AJMartel/defusable_arduino_shield/README.md

# Defusable Alarm Clock Shield for Arduino

Deze github bevat de software, datasheets en referentie materiaal incl. printplaat bestanden van het Defusable Alarm Clock Shield voor Arduino.

J.A. Korten - 2017
