AJMartel/defusable_arduino_shield/Hardware/Shield 1.2/7Segments_displays.png

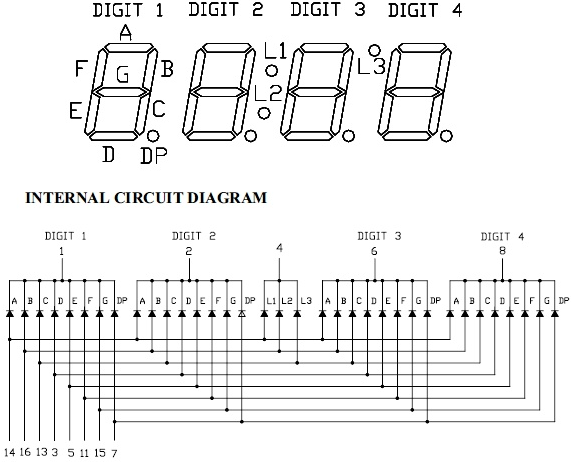
Hardware/Shield 1.2/7Segments_displays.png
