AJMartel/defusable_arduino_shield/Hardware/Shield 1.2/led_matrix_scham.png

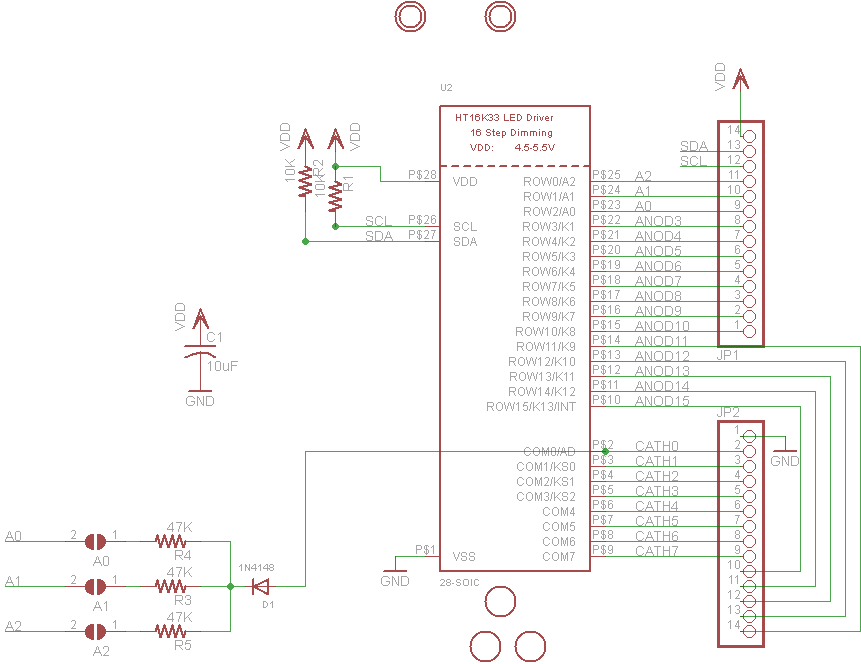
Hardware/Shield 1.2/led_matrix_scham.png
