AJMartel/defusable_arduino_shield/Hardware/Shield 1.2/bombclock_1.3.brd

## EAGLE design Hardware/Shield 1.2/bombclock_1.3.brd (2017-04-16)

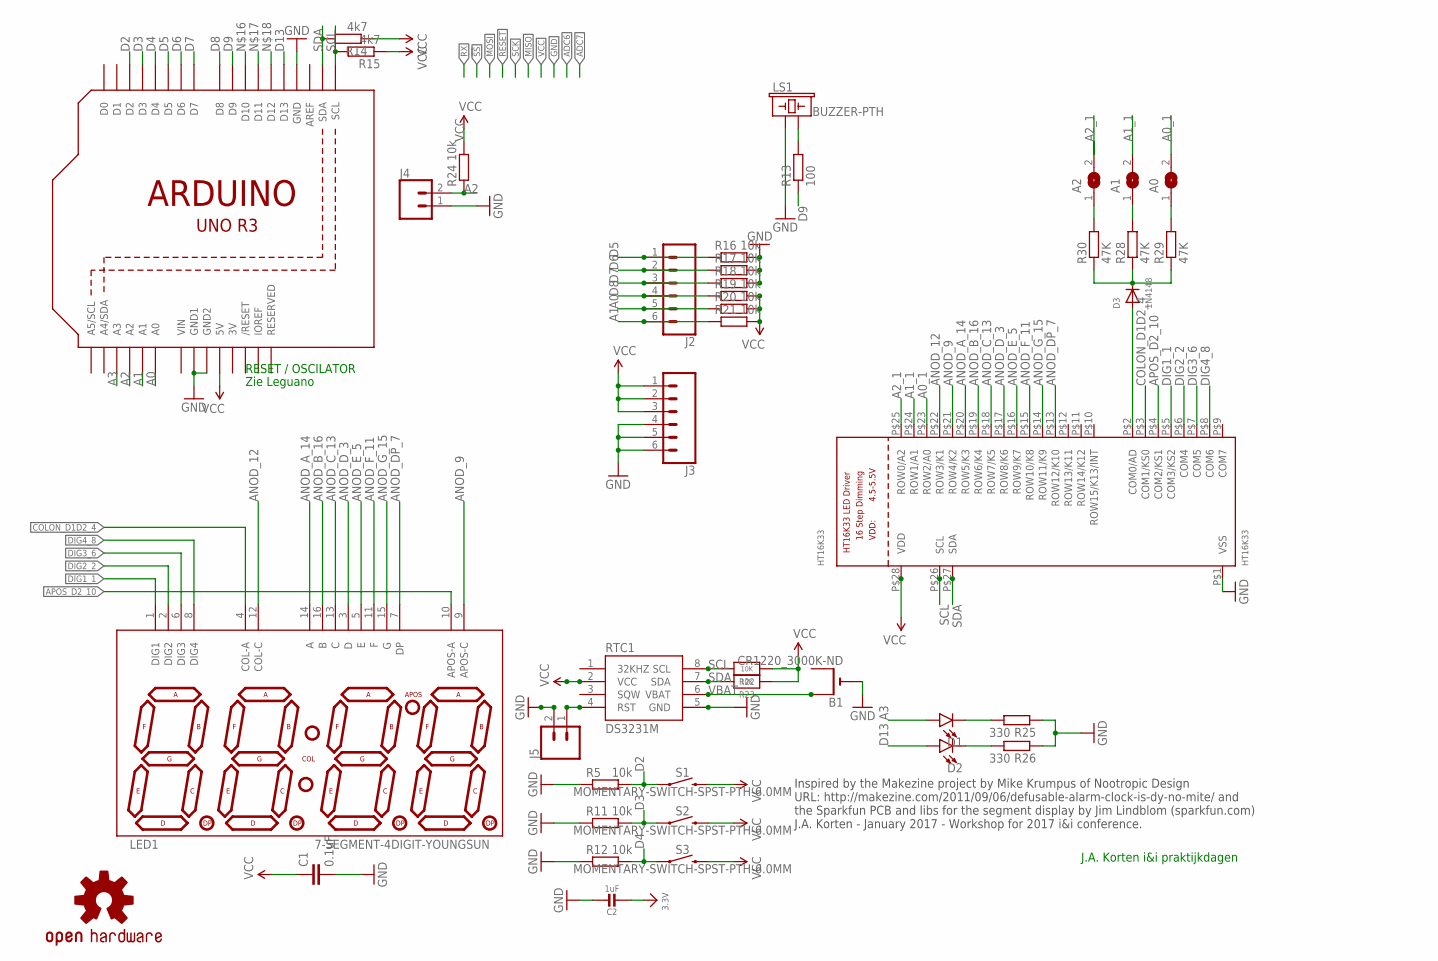
[picture p26: schematic bombclock_1.3.sch]

Parts:
A0, A1, A2: SOLDERJUMPERREFLOW_NOPASTE; SOLDERJUMPER_REFLOW_NOPASTE
B1: CR1220_3000K-ND; CR1220-SMD
C1: 0.1uF; 0402-CAP
C2: 1uF; 0805-NO
D1, D2: LED5MM; LED_5MM
D3: 1N4148; SOD-323F
HT16K33: HT16K33; SOP28_300MIL
J2, J3: CONN_06SILK_FEMALE_PTH; 1X06
J4, J5: CONN_02; 1X02
LED1: 7-SEGMENT-4DIGIT-YOUNGSUN
LS1: BUZZER-PTH; BUZZER-12MM
R5, R11, R12, R16, R17, R18, R19, R20, R21, R24: 10k; R0603
R13: 100; R0603
R14, R15: 4k7; R0603
R22, R23: 10K; 0805-NO
R25, R26: 330; R0603
R28, R29, R30: 47K; R0603
RTC1: DS3231M; SO08
S1, S2, S3: MOMENTARY-SWITCH-SPST-PTH-6.0MM; TACTILE_SWITCH_PTH_6.0MM
U1: ARDUINOR3-DIMENSION; ARDUINOR3
U$4: OSHW-LOGOS; OSHW-LOGO-S

Connections:
3.3V: C2.2
3V: U1.3V
A0: J2.5, R20.1, U1.A0
A0_1: A0.2, HT16K33.P$23 (ROW2/A0)
A1: J2.6, R21.1, U1.A1
A1_1: A1.2, HT16K33.P$24 (ROW1/A1)
A2: J4.2, R24.1, U1.A2
A2_1: A2.2, HT16K33.P$25 (ROW0/A2)
A3: D1.A, U1.A3
ANOD_9: HT16K33.P$21 (ROW4/K2), LED1.9 (APOS-C)
ANOD_12: HT16K33.P$22 (ROW3/K1), LED1.12 (COL-C)
ANOD_A_14: HT16K33.P$20 (ROW5/K3), LED1.14 (A)
ANOD_B_16: HT16K33.P$19 (ROW6/K4), LED1.16 (B)
ANOD_C_13: HT16K33.P$18 (ROW7/K5), LED1.13 (C)
ANOD_DP_7: HT16K33.P$13 (ROW12/K10), LED1.7 (DP)
ANOD_D_3: HT16K33.P$17 (ROW8/K6), LED1.3 (D)
ANOD_E_5: HT16K33.P$16 (ROW9/K7), LED1.5 (E)
ANOD_F_11: HT16K33.P$15 (ROW10/K8), LED1.11 (F)
ANOD_G_15: HT16K33.P$14 (ROW11/K9), LED1.15 (G)
APOS_D2_10: HT16K33.P$4 (COM2/KS1), LED1.10 (APOS-A)
COLON_D1D2_4: HT16K33.P$3 (COM1/KS0), LED1.4 (COL-A)
D2: R5.2, S1.1, U1.D2
D3: R11.2, S2.1, U1.D3
D4: R12.2, S3.1, U1.D4
D5: J2.1, R16.1, U1.D5
D6: J2.2, R17.1, U1.D6
D7: J2.3, R18.1, U1.D7
D8: J2.4, R19.1, U1.D8
D9: R13.1, U1.D9
D13: D2.A, U1.D13
DIG1_1: HT16K33.P$5 (COM3/KS2), LED1.1 (DIG1)
DIG2_2: HT16K33.P$6 (COM4), LED1.2 (DIG2)
DIG3_6: HT16K33.P$7 (COM5), LED1.6 (DIG3)
DIG4_8: HT16K33.P$8 (COM6), LED1.8 (DIG4)
GND: B1.-, C1.2, C2.1, HT16K33.P$1 (VSS), J3.4, J3.5, J3.6, J4.1, J5.2, LS1.+ (1), R5.1, R11.1, R12.1, R16.2, R17.2, R18.2, R25.1, R26.1, RTC1.5 (GND), U1.GND, U1.GND1, U1.GND2
unnamed: A0.1, R29.2
unnamed: D3.A, HT16K33.P$2 (COM0/AD)
unnamed: D1.K (C), R25.2
unnamed: D2.K (C), R26.2
unnamed: A1.1, R28.2
unnamed: LS1.- (2), R13.2
unnamed: D3.C, R28.1, R29.1, R30.1
unnamed: A2.1, R30.2
PP: J5.1, RTC1.4 (RST)
SCL: HT16K33.P$26 (SCL), R15.2, R22.2, RTC1.8 (SCL), U1.SCL
SDA: HT16K33.P$27 (SDA), R14.2, R23.2, RTC1.7 (SDA), U1.SDA
VBAT: B1.+$1 (+), RTC1.6 (VBAT)
VCC: C1.1, HT16K33.P$28 (VDD), J3.1, J3.2, J3.3, R14.1, R15.1, R19.2, R20.2, R21.2, R22.1, R23.1, R24.2, RTC1.2 (VCC), S1.3 (2), S2.3 (2), S3.3 (2), U1.5V
VIN: U1.VIN

Notes on the sheet:
Inspired by the Makezine project by Mike Krumpus of Nootropic Design URL: http://makezine.com/2011/09/06/defusable-alarm-clock-is-dy-no-mite/ and the Sparkfun PCB and libs for the segment display by Jim Lindblom (sparkfun.com) J.A. Korten - January 2017 - Workshop for 2017 i&i conference.
RESET / OSCILATOR
Zie Leguano
J.A. Korten i&i praktijkdagen

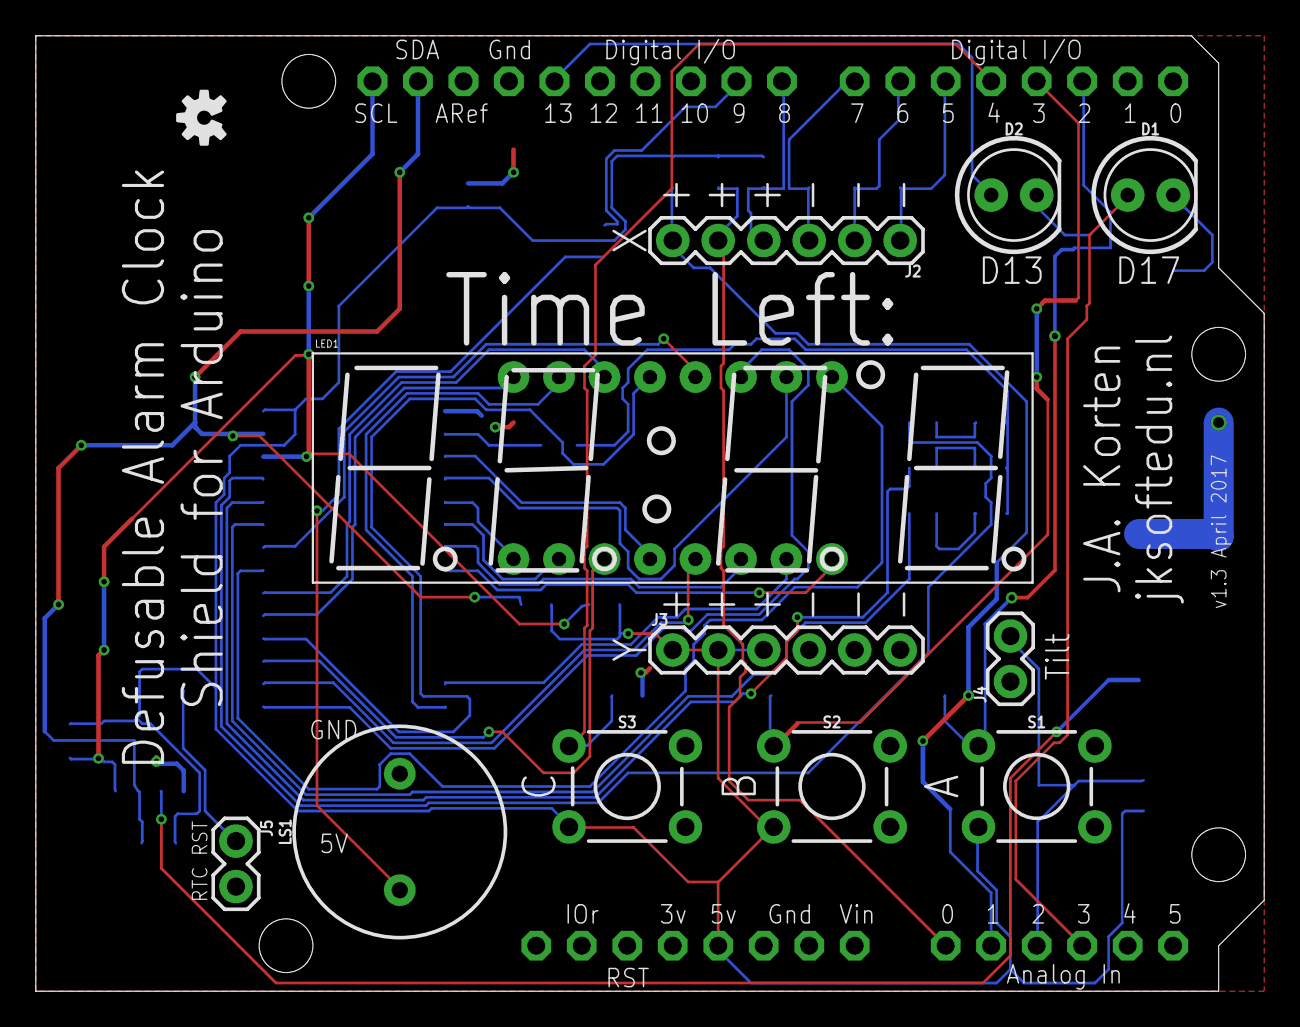
[picture p27: board bombclock_1.3.brd from above]

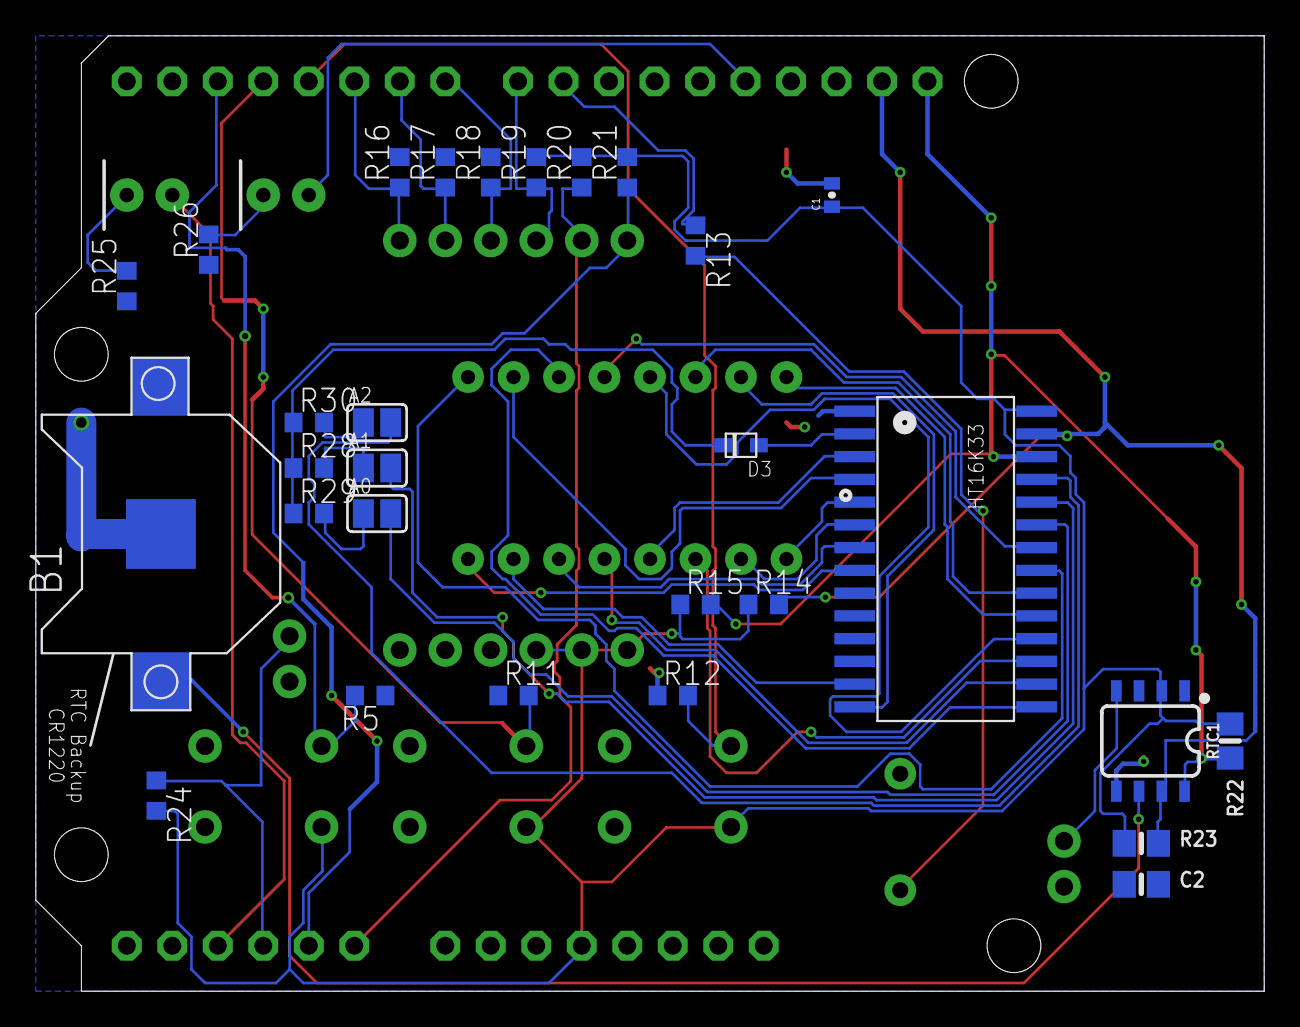
[picture p28: board bombclock_1.3.brd from below]

Board: 2 copper layers, 68.6 x 53.3 mm, 42 parts (29 on the bottom side), 46 nets.
