AJMartel/defusable_arduino_shield/Hardware/Shield/bombclock_1.0.1.brd

## EAGLE design Hardware/Shield/bombclock_1.0.1.brd (2017-01-31)

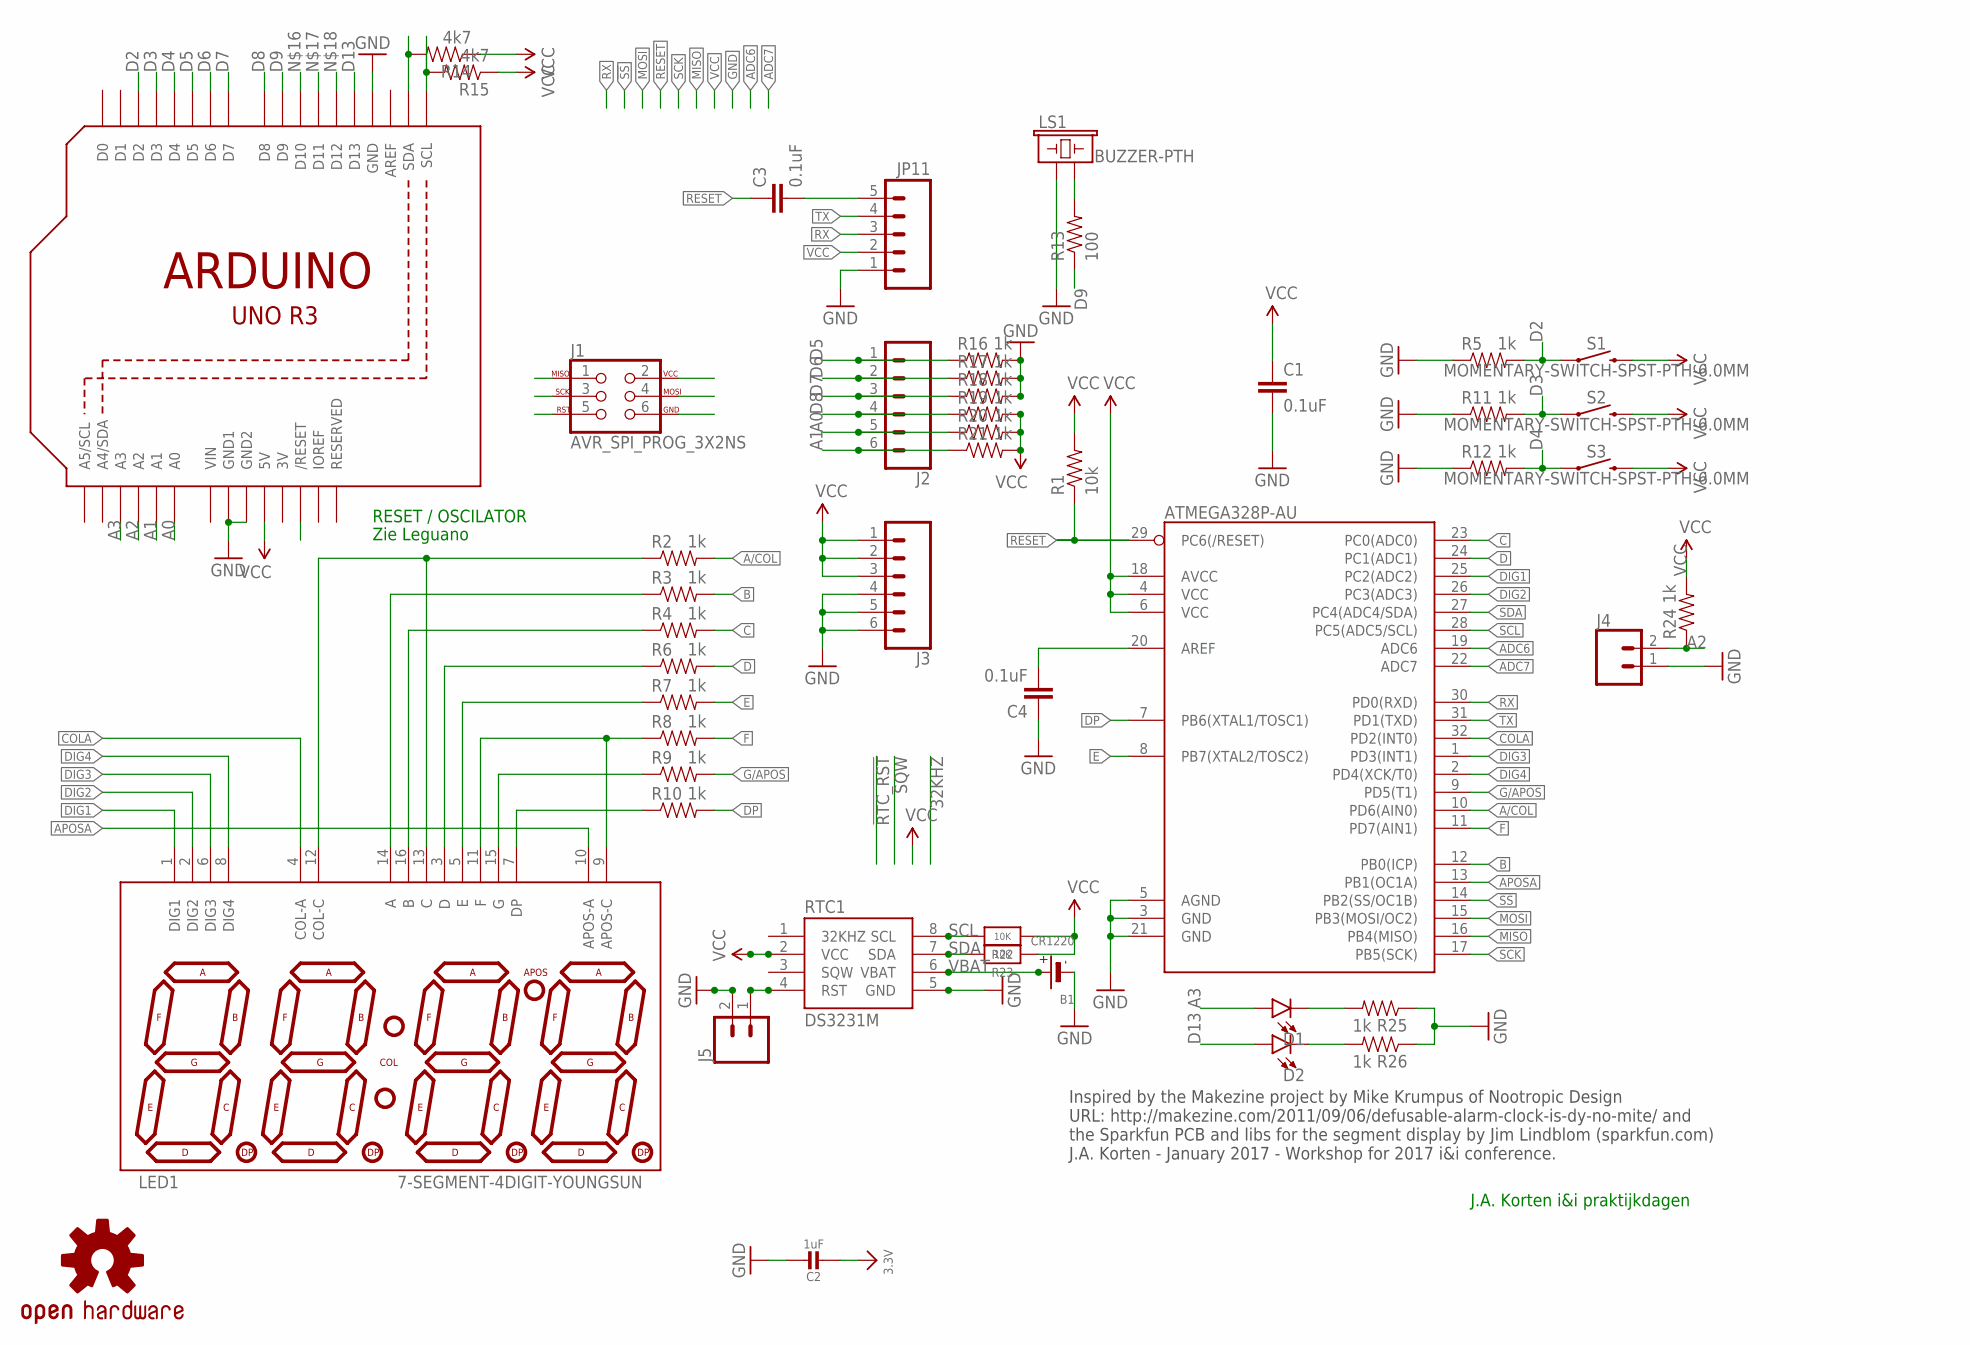
[picture p29: schematic bombclock_1.0.1.sch]

Parts:
ATMEGA328P-AU: ATMEGA328P-AU; TQFP32-08
B1: CR1220
C1, C3, C4: 0.1uF; 0402-CAP
C2: 1uF; 0805-NO
D1, D2: LED5MM; LED_5MM
J1: AVR_SPI_PROG_3X2NS; 2X3-NS
J2, J3: CONN_06SILK_FEMALE_PTH; 1X06
J4, J5: CONN_02; 1X02
JP11: M05PTH-NS; 1X05_NO_SILK
LED1: 7-SEGMENT-4DIGIT-YOUNGSUN
LS1: BUZZER-PTH; BUZZER-12MM
R1: 10k; 0402-RES
R2, R3, R4, R5, R6, R7, R8, R9, R10, R11, R12, R16, R17, R18, R19, R20, R21, R24, R25, R26: 1k; 0402-RES
R13: 100; 0402-RES
R14, R15: 4k7; 0402-RES
R22, R23: 10K; 0805-NO
RTC1: DS3231M; SO08
S1, S2, S3: MOMENTARY-SWITCH-SPST-PTH-6.0MM; TACTILE_SWITCH_PTH_6.0MM
U1: ARDUINOR3-DIMENSION; ARDUINOR3
U$4: OSHW-LOGOS; OSHW-LOGO-S

Connections:
3.3V: C2.2
3V: U1.3V
!SS: ATMEGA328P-AU.14 (PB2(SS/OC1B))
A0: J2.5, R20.1, U1.A0
A1: J2.6, R21.1, U1.A1
A2: J4.2, R24.1, U1.A2
A3: D1.A, U1.A3
A/COL: ATMEGA328P-AU.10 (PD6(AIN0)), R2.2
ADC6: ATMEGA328P-AU.19 (ADC6)
ADC7: ATMEGA328P-AU.22 (ADC7)
APOSA: ATMEGA328P-AU.13 (PB1(OC1A)), LED1.10 (APOS-A)
B: ATMEGA328P-AU.12 (PB0(ICP)), R3.2
C: ATMEGA328P-AU.23 (PC0(ADC0)), R4.2
COLA: ATMEGA328P-AU.32 (PD2(INT0)), LED1.4 (COL-A)
D: ATMEGA328P-AU.24 (PC1(ADC1)), R6.2
D2: R5.2, S1.1, U1.D2
D3: R11.2, S2.1, U1.D3
D4: R12.2, S3.1, U1.D4
D5: J2.1, R16.1, U1.D5
D6: J2.2, R17.1, U1.D6
D7: J2.3, R18.1, U1.D7
D8: J2.4, R19.1, U1.D8
D9: R13.1, U1.D9
D13: D2.A, U1.D13
DIG1: ATMEGA328P-AU.25 (PC2(ADC2)), LED1.1 (DIG1)
DIG2: ATMEGA328P-AU.26 (PC3(ADC3)), LED1.2 (DIG2)
DIG3: ATMEGA328P-AU.1 (PD3(INT1)), LED1.6 (DIG3)
DIG4: ATMEGA328P-AU.2 (PD4(XCK/T0)), LED1.8 (DIG4)
DP: ATMEGA328P-AU.7 (PB6(XTAL1/TOSC1)), R10.2
E: ATMEGA328P-AU.8 (PB7(XTAL2/TOSC2)), R7.2
F: ATMEGA328P-AU.11 (PD7(AIN1)), R8.2
G/APOS: ATMEGA328P-AU.9 (PD5(T1)), R9.2
GND: ATMEGA328P-AU.3 (GND), ATMEGA328P-AU.5 (AGND), ATMEGA328P-AU.21 (GND), B1.-, C1.2, C2.1, C4.1, J1.6, J3.4, J3.5, J3.6, J4.1, J5.2, JP11.1, LS1.+ (1), R5.1, R11.1, R12.1, R16.2, R17.2, R18.2, R25.1, R26.1, RTC1.5 (GND), U1.GND, U1.GND1, U1.GND2
MISO: ATMEGA328P-AU.16 (PB4(MISO)), J1.1
MOSI: ATMEGA328P-AU.15 (PB3(MOSI/OC2)), J1.4
unnamed: ATMEGA328P-AU.20 (AREF), C4.2
unnamed: LED1.7 (DP), R10.1
unnamed: LED1.15 (G), R9.1
unnamed: LED1.9 (APOS-C), LED1.11 (F), R8.1
unnamed: LED1.5 (E), R7.1
unnamed: LED1.3 (D), R6.1
unnamed: LED1.16 (B), R4.1
unnamed: LED1.14 (A), R3.1
unnamed: LED1.12 (COL-C), LED1.13 (C), R2.1
unnamed: D1.K (C), R25.2
unnamed: C3.2, JP11.5
unnamed: D2.K (C), R26.2
unnamed: LS1.- (2), R13.2
PP: J5.1, RTC1.4 (RST)
RESET: ATMEGA328P-AU.29 (PC6(/RESET)), C3.1, J1.5, R1.1
RST_UNO: U1.RESET (/RESET)
RX: ATMEGA328P-AU.30 (PD0(RXD)), JP11.3
SCK: ATMEGA328P-AU.17 (PB5(SCK)), J1.3
SCL: ATMEGA328P-AU.28 (PC5(ADC5/SCL)), R15.2, R22.2, RTC1.8 (SCL), U1.SCL
SDA: ATMEGA328P-AU.27 (PC4(ADC4/SDA)), R14.2, R23.2, RTC1.7 (SDA), U1.SDA
TX: ATMEGA328P-AU.31 (PD1(TXD)), JP11.4
VBAT: B1.+$1 (+), RTC1.6 (VBAT)
VCC: ATMEGA328P-AU.4 (VCC), ATMEGA328P-AU.6 (VCC), ATMEGA328P-AU.18 (AVCC), C1.1, J1.2, J3.1, J3.2, J3.3, JP11.2, R1.2, R14.1, R15.1, R19.2, R20.2, R21.2, R22.1, R23.1, R24.2, RTC1.2 (VCC), S1.3 (2), S2.3 (2), S3.3 (2), U1.5V
VIN: U1.VIN

Notes on the sheet:
Inspired by the Makezine project by Mike Krumpus of Nootropic Design URL: http://makezine.com/2011/09/06/defusable-alarm-clock-is-dy-no-mite/ and the Sparkfun PCB and libs for the segment display by Jim Lindblom (sparkfun.com) J.A. Korten - January 2017 - Workshop for 2017 i&i conference.
RESET / OSCILATOR
Zie Leguano
J.A. Korten i&i praktijkdagen

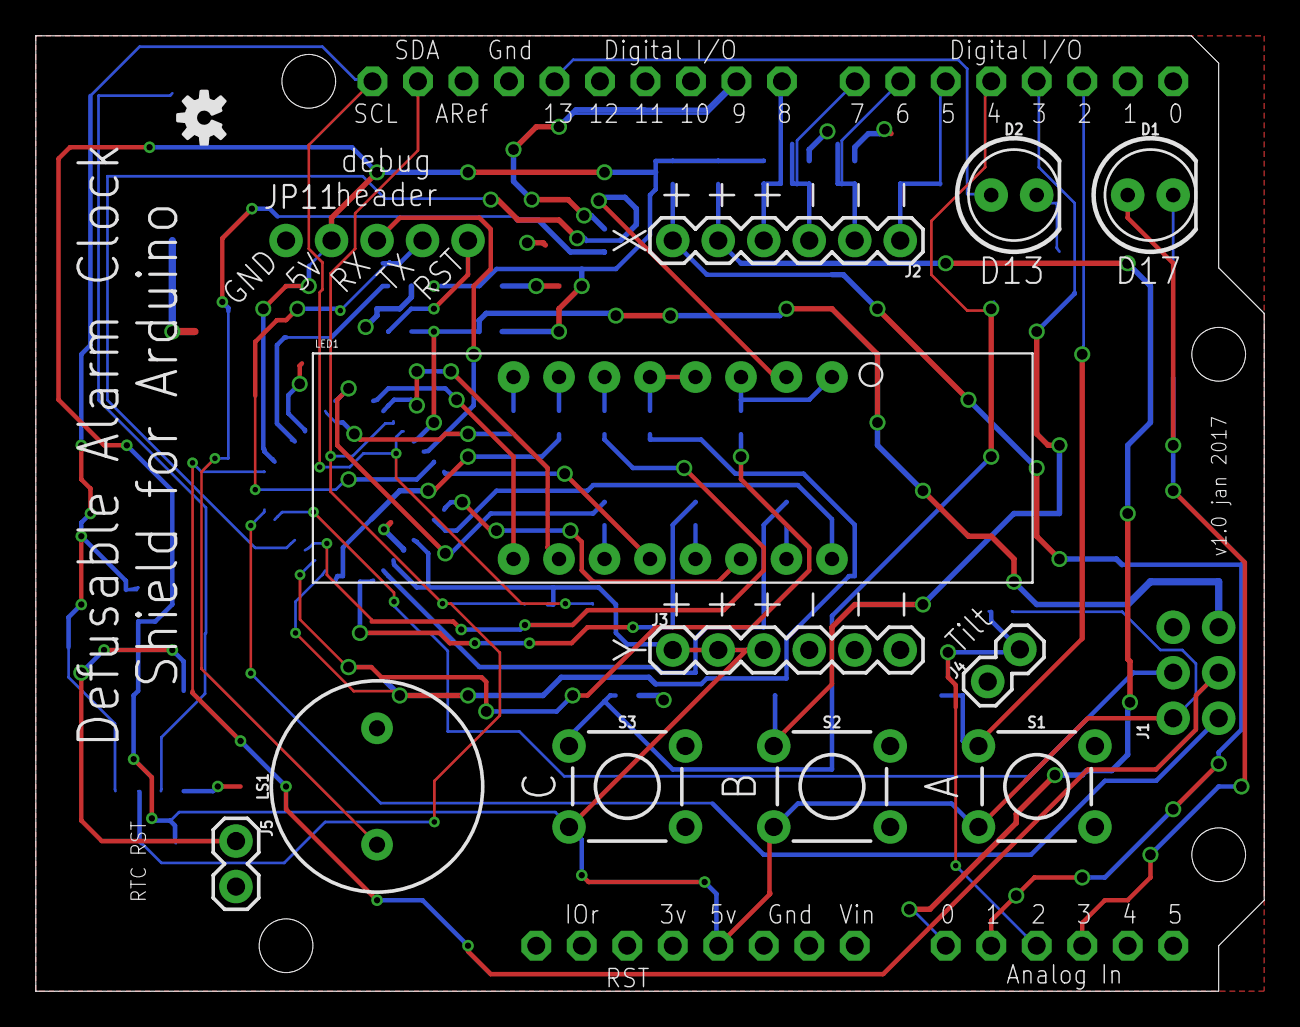
[picture p30: board bombclock_1.0.1.brd from above]

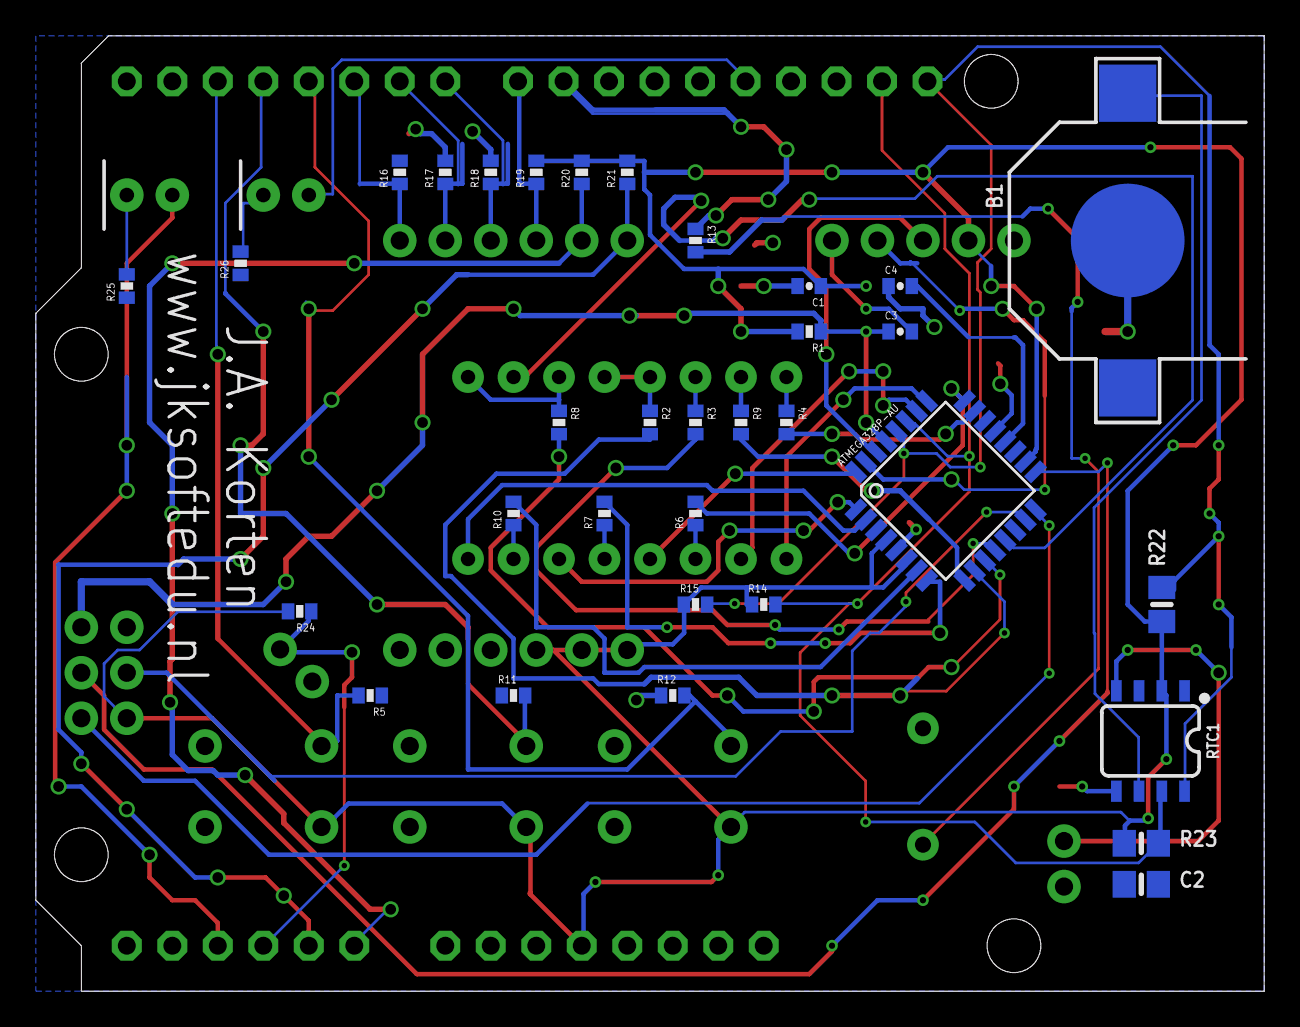
[picture p31: board bombclock_1.0.1.brd from below]

Board: 2 copper layers, 68.6 x 53.3 mm, 48 parts (33 on the bottom side), 52 nets.
