AJMartel/defusable_arduino_shield/(commit log)

2017-01-31 Example files
    Example files
    [bombclock_1.0.1.brd, bombclock_1.0.1.sch]
2017-04-16 Updates
    Updates
    [bombclock_1.2.GBL, bombclock_1.2.GBO, bombclock_1.2.GBP, bombclock_1.2.GBS, bombclock_1.2.GKO, bombclock_1.2.GTL, bombclock_1.2.GTO, bombclock_1.2.GTP]
2017-04-18 Added i2c scanner
    Added i2c scanner
2017-04-19 Update van de presentatie
    Update van de presentatie, foutjes opgelost.
